jabolos10/Autonomous_car_controlled_by_the_direction_of_the_sound/(commit log)

2026-07-09 Autonomous car controlled by the direction of the sound
    ESP32-S3 rover with 4-microphone sound localisation, automatic
    motor control, and a live Wi-Fi web dashboard. Includes firmware,
    circuit schematics, and the full project report.
2026-07-09 Translate all remaining Polish comments/strings to English
    Firmware comments, section headers, and Serial.println() messages
    in both sketches are now fully in English; code logic unchanged.
2026-07-09 Add demo video of the car in action
    Recorded clip showing the full listen -> decide -> drive -> dashboard
    cycle, compressed to H.264/MP4 for a smaller repo footprint.
